baochip/longbao/longbao_hdi_v1/longbao_hdi_v1.kicad_pcb

## KiCad design longbao_hdi_v1/longbao_hdi_v1.kicad_pcb (2026-10-25)

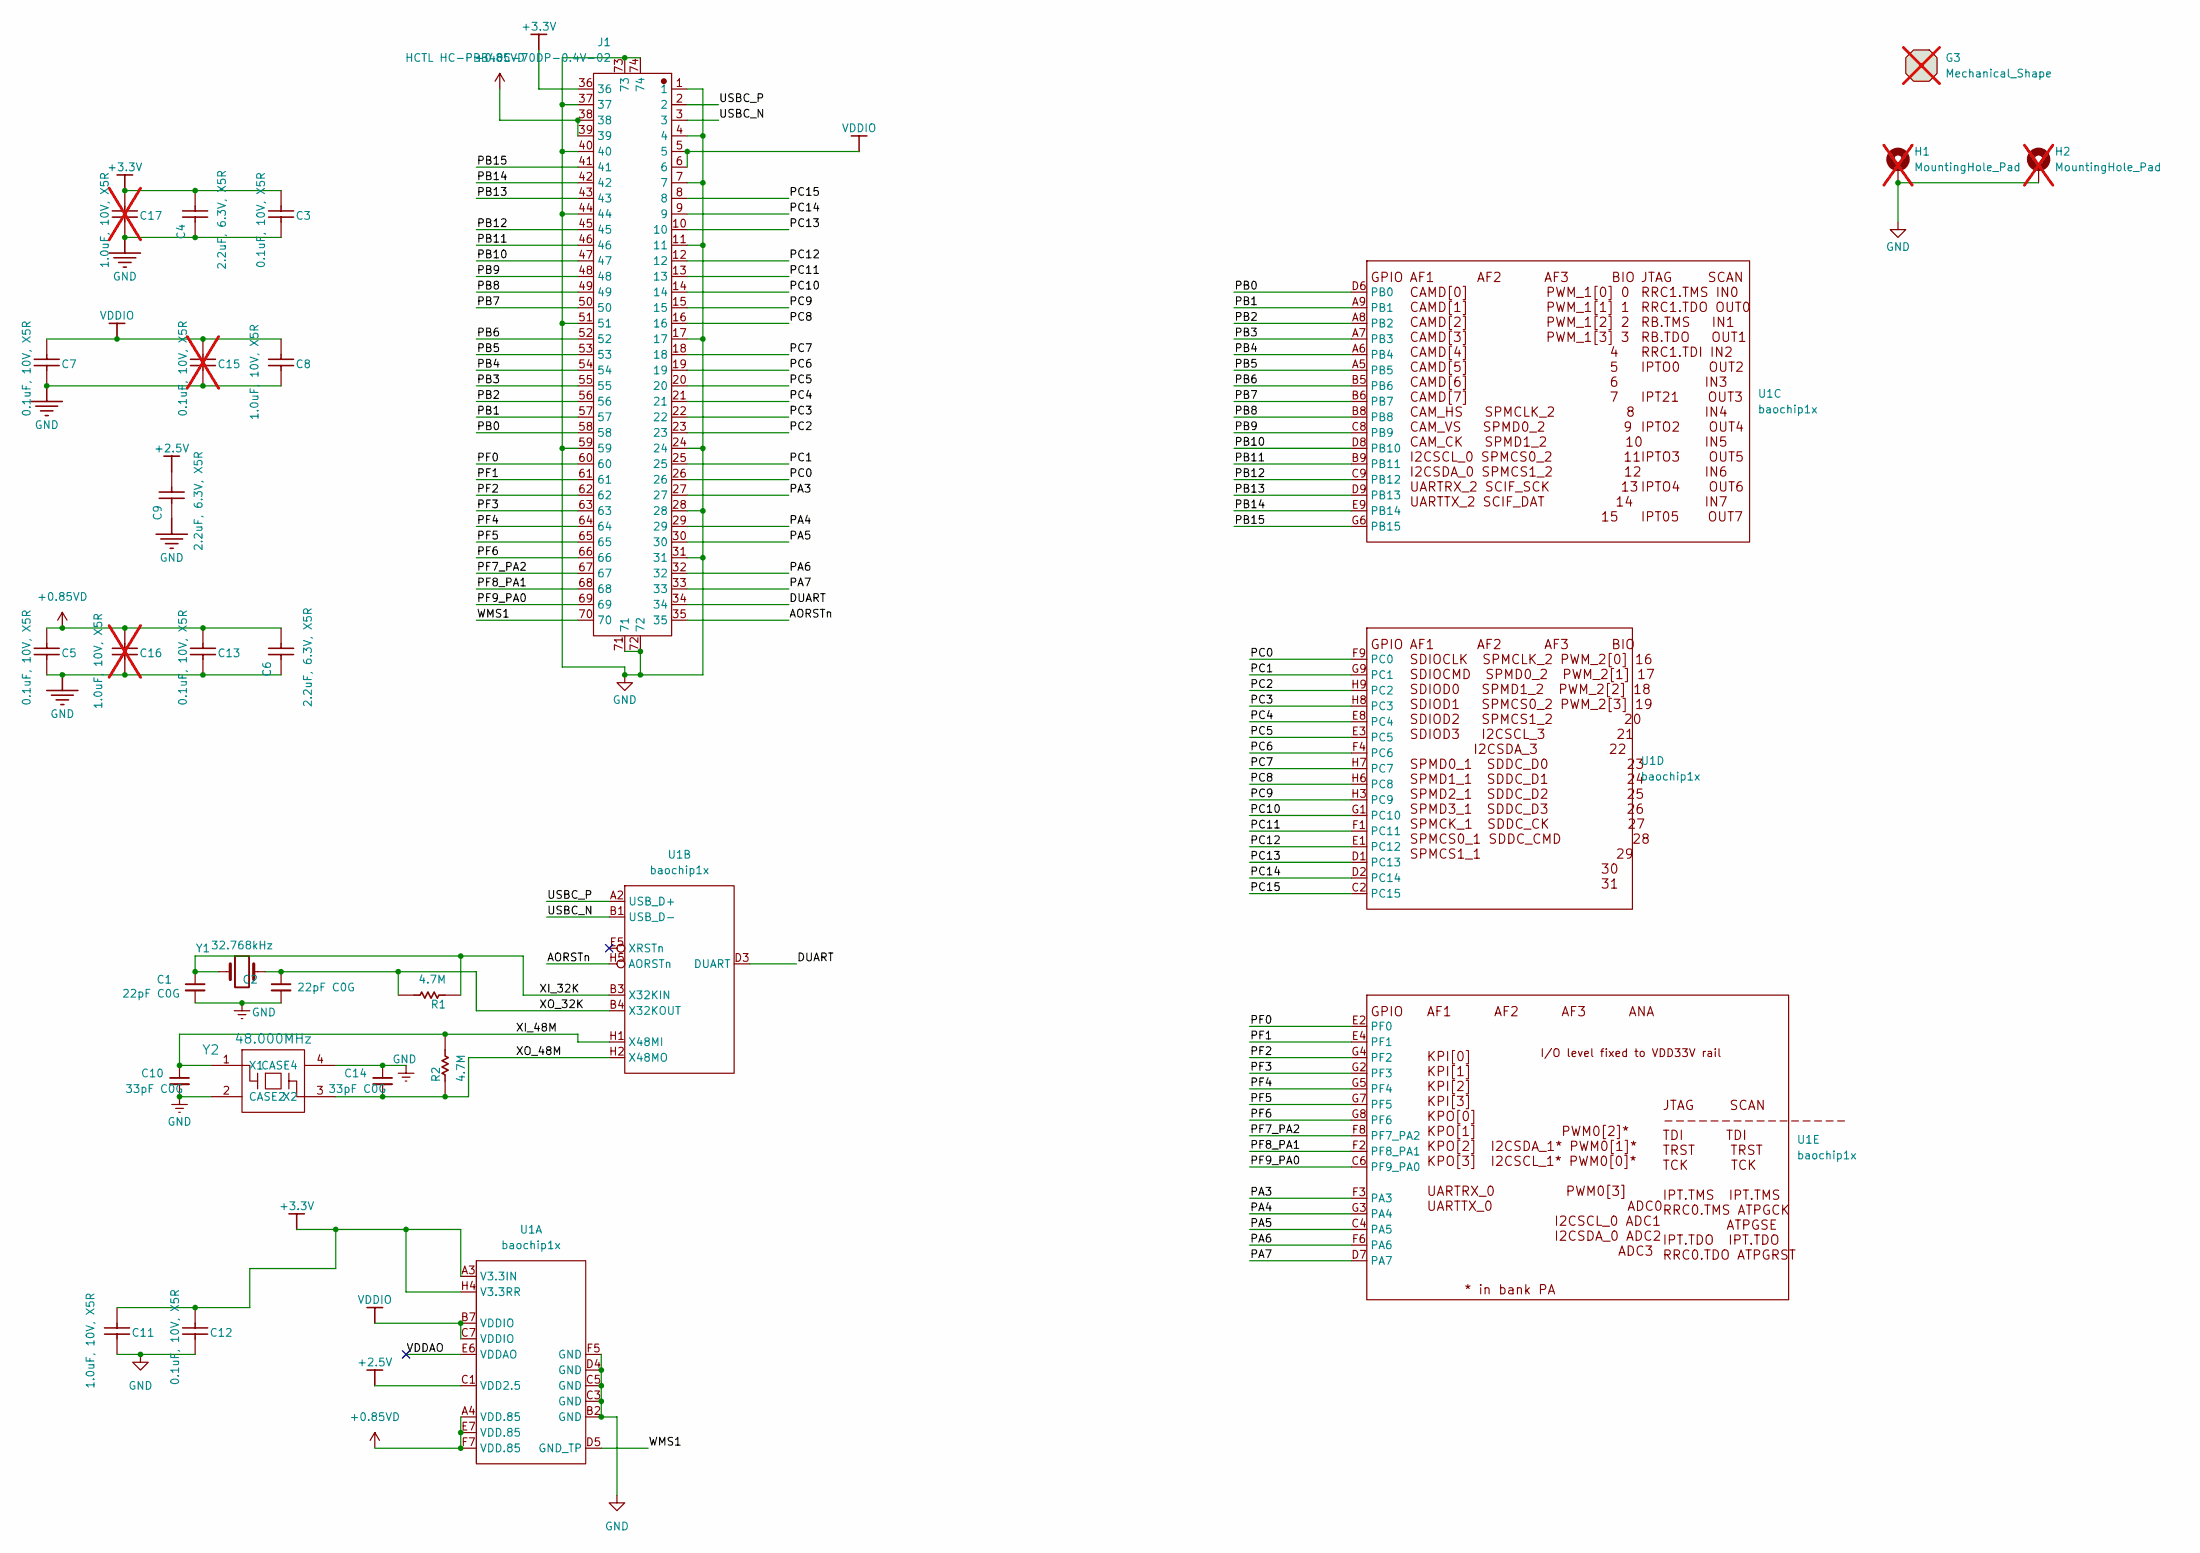
[picture p1: schematic longbao_hdi_v1.kicad_sch]

Parts:
C1, C2: 22pF C0G; C_0201_0603Metric; Rating C0G 50V 0201; MPN ANY; LCSC C57783
C3, C5, C7, C12, C13: 0.1uF, 10V, X5R; C_0201_0603Metric; MPN CL05B104KO5NNNC; LCSC C76934
C4, C6, C9: 2.2uF, 6.3V, X5R; C_0201_0603Metric; MPN GRM033R60J225ME47D; LCSC C76933
C8, C11: 1.0uF, 10V, X5R; C_0201_0603Metric; MPN CL05A105KA5NQNC; LCSC C76935
C10, C14: 33pF C0G; C_0201_0603Metric; Rating C0G 50V 0201; MPN ANY; LCSC C56903
C15: 0.1uF, 10V, X5R; C_0201_0603Metric; MPN CL05B104KO5NNNC; LCSC C76934; not fitted
C16, C17: 1.0uF, 10V, X5R; C_0201_0603Metric; MPN CL05A105KA5NQNC; LCSC C76935; not fitted
G3: Mechanical_Shape; CE-Logo_8.5x6mm_SilkScreen; not fitted
H1, H2: MountingHole_Pad; MountingHole_2.2mm_M2_DIN965_Pad; not fitted
J1: HCTL HC-PBB40C-70DP-0.4V-02; HC-PBB40C-70DP-0.4V-02; LCSC C19089236
R1, R2: 4.7M; R_0402_1005Metric; MPN ANY; LCSC C474132
U1: baochip1x; WLCSP-71_9x8_4.062x3.762mm; LCSC C9900312212
Y1: 32.768kHz; Crystal_SMD_TXC_9HT11-2Pin_2.0x1.2mm; LCSC C55208
Y2: 48.000MHz; Crystal_SMD_3225-4Pin_3.2x2.5mm; LCSC C2892060

Connections:
+0.85VD: C5.1, C6.2, C13.1, C16.1, J1.38, J1.39, U1.A4 (VDD.85), U1.E7 (VDD.85), U1.F7 (VDD.85)
+2.5V: C9.2, U1.C1 (VDD2.5)
+3.3V: C3.1, C4.2, C11.1, C12.1, C17.1, J1.36, U1.A3 (V3.3IN), U1.H4 (V3.3RR)
/AORSTn: J1.35, U1.H5 (AORSTn)
/DUART: J1.34, U1.D3 (DUART)
/PA3: J1.27, U1.F3 (PA3)
/PA4: J1.29, U1.G3 (PA4)
/PA5: J1.30, U1.C4 (PA5)
/PA6: J1.32, U1.F6 (PA6)
/PA7: J1.33, U1.D7 (PA7)
/PB0: J1.58, U1.D6 (PB0)
/PB1: J1.57, U1.A9 (PB1)
/PB2: J1.56, U1.A8 (PB2)
/PB3: J1.55, U1.A7 (PB3)
/PB4: J1.54, U1.A6 (PB4)
/PB5: J1.53, U1.A5 (PB5)
/PB6: J1.52, U1.B5 (PB6)
/PB7: J1.50, U1.B6 (PB7)
/PB8: J1.49, U1.B8
/PB9: J1.48, U1.C8 (PB9)
/PB10: J1.47, U1.D8 (PB10)
/PB11: J1.46, U1.B9 (PB11)
/PB12: J1.45, U1.C9 (PB12)
/PB13: J1.43, U1.D9 (PB13)
/PB14: J1.42, U1.E9 (PB14)
/PB15: J1.41, U1.G6 (PB15)
/PC0: J1.26, U1.F9 (PC0)
/PC1: J1.25, U1.G9 (PC1)
/PC2: J1.23, U1.H9 (PC2)
/PC3: J1.22, U1.H8 (PC3)
/PC4: J1.21, U1.E8 (PC4)
/PC5: J1.20, U1.E3 (PC5)
/PC6: J1.19, U1.F4 (PC6)
/PC7: J1.18, U1.H7 (PC7)
/PC8: J1.16, U1.H6 (PC8)
/PC9: J1.15, U1.H3 (PC9)
/PC10: J1.14, U1.G1 (PC10)
/PC11: J1.13, U1.F1 (PC11)
/PC12: J1.12, U1.E1 (PC12)
/PC13: J1.10, U1.D1 (PC13)
/PC14: J1.9, U1.D2 (PC14)
/PC15: J1.8, U1.C2 (PC15)
/PF0: J1.60, U1.E2 (PF0)
/PF1: J1.61, U1.E4 (PF1)
/PF2: J1.62, U1.G4 (PF2)
/PF3: J1.63, U1.G2 (PF3)
/PF4: J1.64, U1.G5 (PF4)
/PF5: J1.65, U1.G7 (PF5)
/PF6: J1.66, U1.G8 (PF6)
/PF7_PA2: J1.67, U1.F8 (PF7_PA2)
/PF8_PA1: J1.68, U1.F2 (PF8_PA1)
/PF9_PA0: J1.69, U1.C6 (PF9_PA0)
/USBC_N: J1.3, U1.B1 (USB_D-)
/USBC_P: J1.2, U1.A2 (USB_D+)
/VDDAO: U1.E6 (VDDAO)
/WMS1: J1.70, U1.D5 (GND_TP)
/XI_32K: C1.1, R1.1, U1.B3 (X32KIN), Y1.1
/XI_48M: C10.1, R2.2, U1.H1 (X48MI), Y2.1 (X1)
/XO_32K: C2.1, R1.2, U1.B4 (X32KOUT), Y1.2
/XO_48M: C14.2, R2.1, U1.H2 (X48MO), Y2.3 (X2)
GND: C1.2, C2.2, C3.2, C4.1, C5.2, C6.1, C7.2, C8.2, C9.1, C10.2, C11.2, C12.2, C13.2, C14.1, C15.2, C16.2, C17.2, H1.1 (1_1), H2.1 (1_1), J1.1, J1.4, J1.7, J1.11, J1.17, J1.24, J1.28, J1.31, J1.37, J1.40, J1.44, J1.51, J1.59, J1.71, J1.72, J1.73, J1.74, U1.B2 (GND), U1.C3 (GND), U1.C5 (GND), U1.D4 (GND), U1.F5 (GND), Y2.2 (CASE2), Y2.4 (CASE4)
VDDIO: C7.1, C8.1, C15.1, J1.5, J1.6, U1.B7 (VDDIO), U1.C7 (VDDIO)

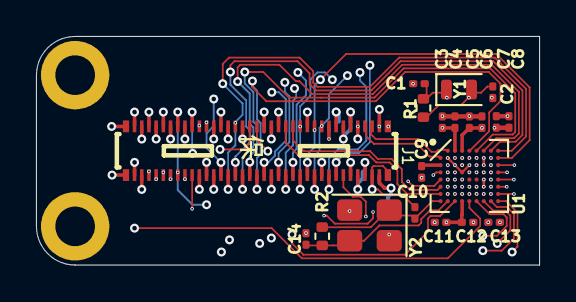
[picture p2: board longbao_hdi_v1.kicad_pcb from above]

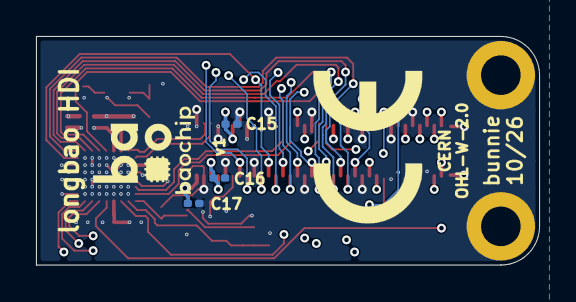
[picture p3: board longbao_hdi_v1.kicad_pcb from below]

Board: 6 copper layers, 28.0 x 12.7 mm, 28 parts (5 on the bottom side), 61 nets.

Other parts of the board:
G1, G2: LOGO
