baochip/longbao/longbao_carrier_v1/longbao_carrier_v1.kicad_pcb

## KiCad design longbao_carrier_v1/longbao_carrier_v1.kicad_pcb (2026-10-25)

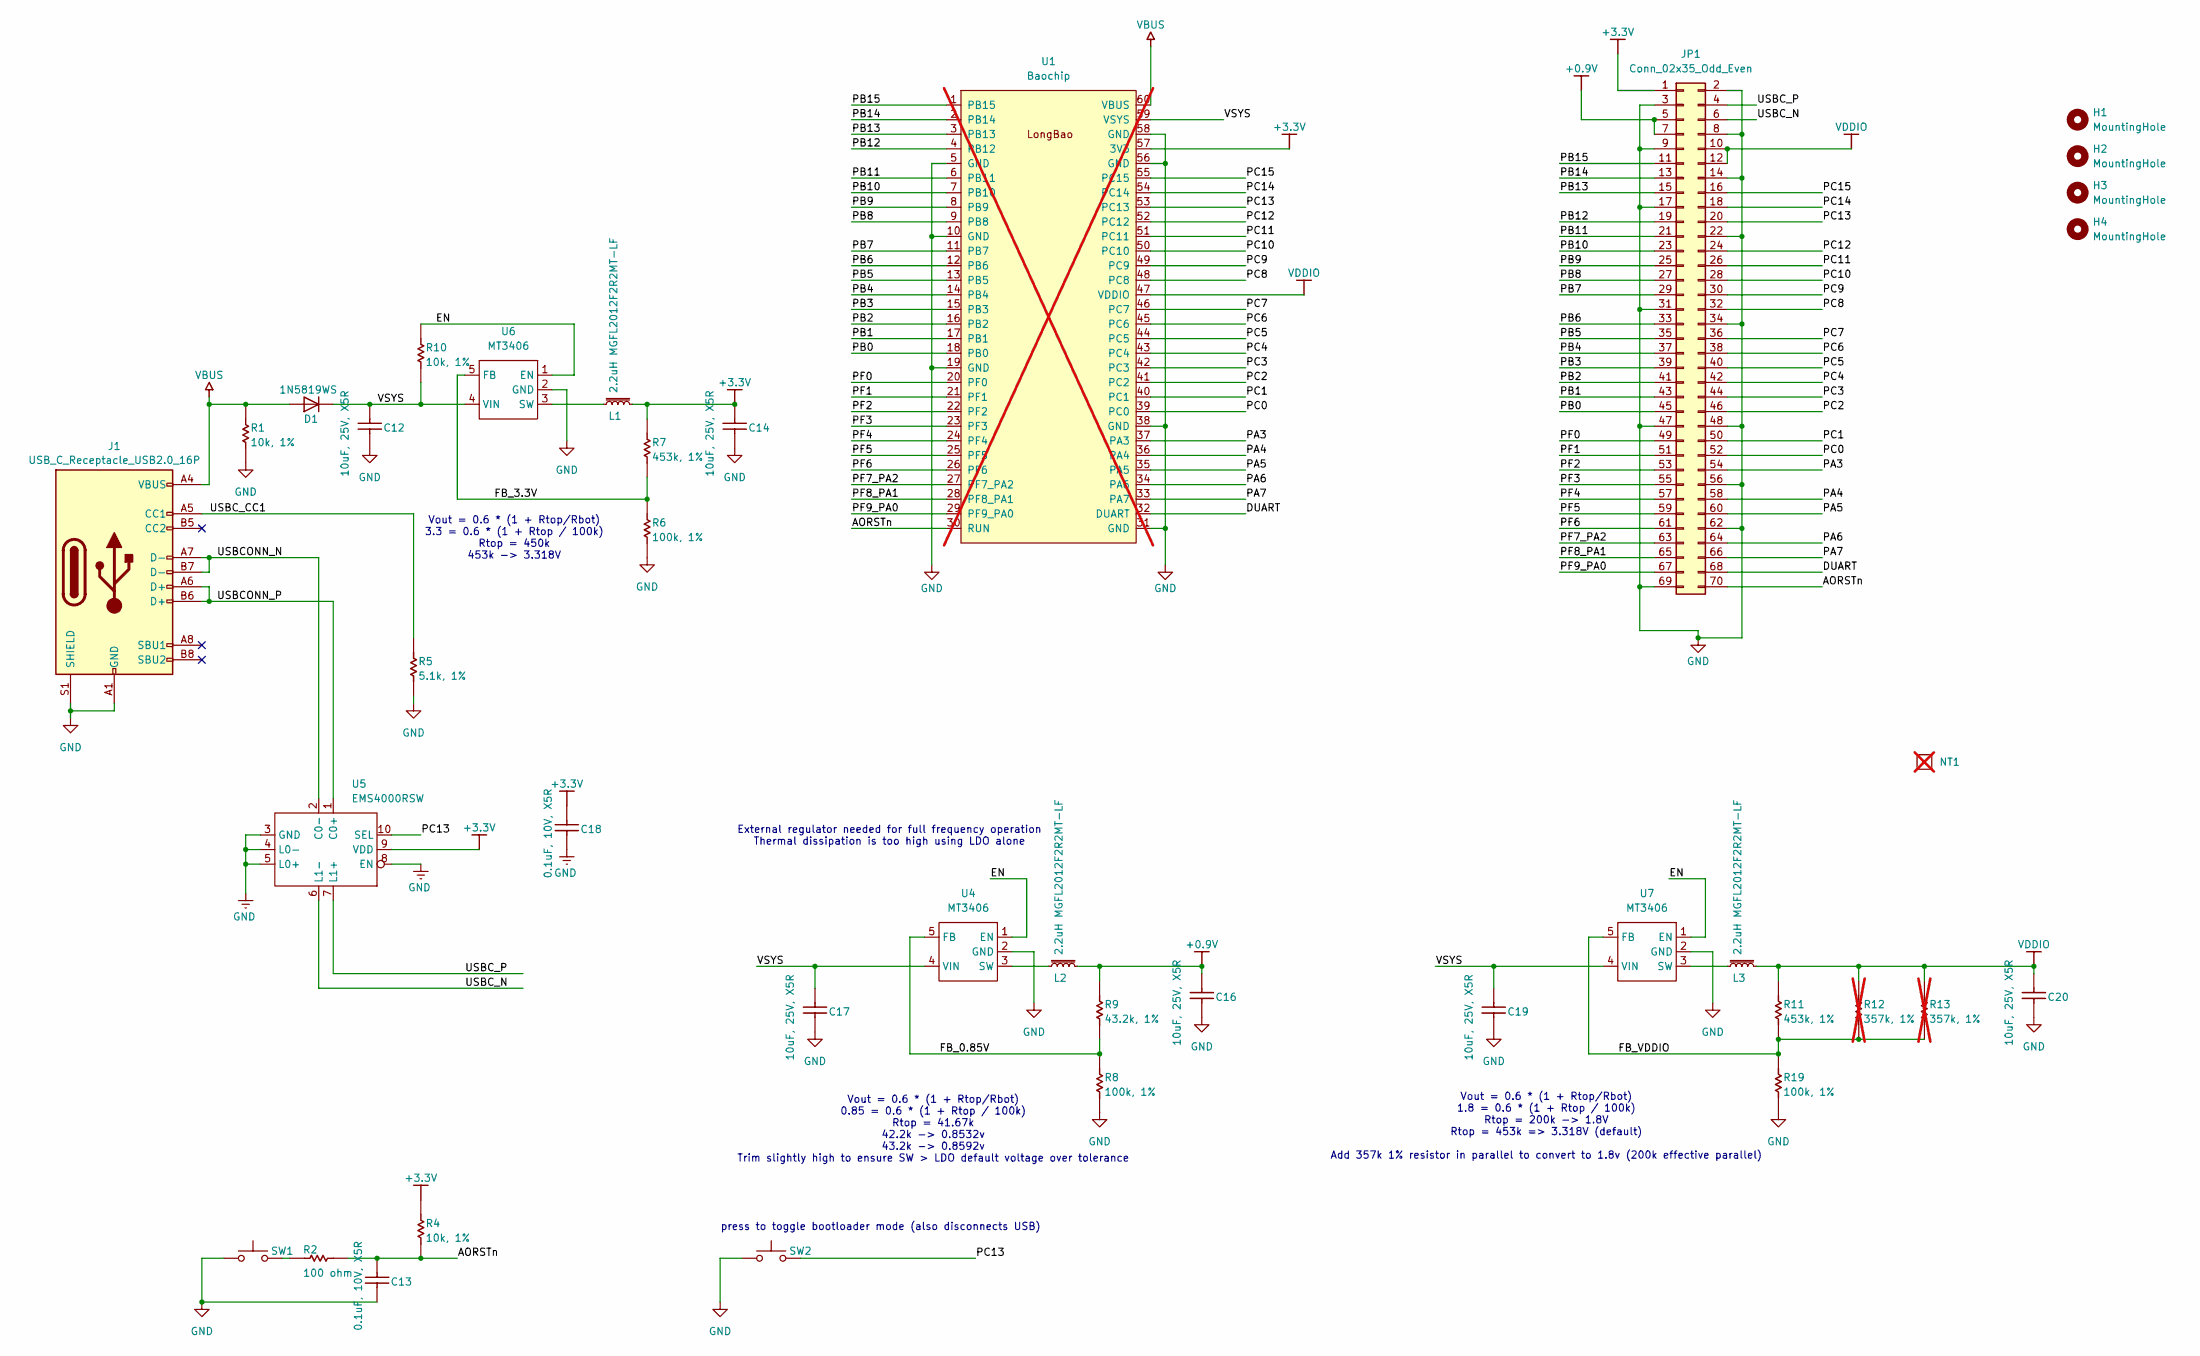
[picture p4: schematic longbao_carrier_v1.kicad_sch]

Parts:
C12, C14, C16, C17, C19, C20: 10uF, 25V, X5R; C_0603_1608Metric; MPN CL10A106MA8NRNC; LCSC C96446
C13, C18: 0.1uF, 10V, X5R; C_0201_0603Metric; MPN CL05B104KO5NNNC; LCSC C76934
D1: 1N5819WS; D_SOD-323; MPN SD103AWS; LCSC C191023
H1, H2, H3, H4: MountingHole; MountingHole_2.2mm_M2_DIN965
J1: USB_C_Receptacle_USB2.0_16P; USB_C_Receptacle_HRO_TYPE-C-31-M-12; LCSC C165948
JP1: Conn_02x35_Odd_Even; HC-PBB40C-70DS-0.4V-2.5-02; LCSC C19089322
L1, L2, L3: 2.2uH MGFL2012F2R2MT-LF; L_0805_2012Metric; LCSC C281115
NT1: CE-Logo_8.5x6mm_SilkScreen; not fitted
R1, R4, R10: 10k, 1%; R_0201_0603Metric; MPN ANY; LCSC C106225
R2: 100 ohm; R_0402_1005Metric; MPN ANY; LCSC C106232
R5: 5.1k, 1%; R_0402_1005Metric; MPN ANY; LCSC C25905
R6, R8, R19: 100k, 1%; R_0201_0603Metric; MPN ANY; LCSC C106224
R7, R11: 453k, 1%; R_0201_0603Metric; MPN ANY; LCSC C423509
R9: 43.2k, 1%; R_0201_0603Metric; MPN ANY; LCSC C158519
R12: 357k, 1%; R_1206_3216Metric; MPN ANY; LCSC DNP; not fitted
R13: 357k, 1%; R_Axial_DIN0207_L6.3mm_D2.5mm_P7.62mm_Horizontal; MPN ANY; LCSC DNP; not fitted
SW1, SW2: SW_Push; TS3425BA; LCSC C2681476
U1: Baochip; Longbao_Vendor_Substrate; not fitted
U4, U6, U7: MT3406; SOT-23-5; LCSC C22462728
U5: EMS4000RSW; QFN-10_1.4x1.8_Pitch0.4mm; LCSC C49186227

Connections:
+0.9V: C16.1, JP1.5, JP1.7, L2.2, R9.1
+3.3V: C14.1, C18.1, JP1.1, L1.2, R4.1, R7.1, U1.57 (3V3), U5.9 (VDD)
/AORSTn: C13.1, JP1.70, R2.2, R4.2, U1.30 (RUN)
/DUART: JP1.68, U1.32 (DUART)
/EN: R10.1, U4.1 (EN), U6.1 (EN), U7.1 (EN)
/FB_0.85V: R8.1, R9.2, U4.5 (FB)
/FB_3.3V: R6.1, R7.2, U6.5 (FB)
/FB_VDDIO: R11.2, R12.2, R13.2, R19.1, U7.5 (FB)
/PA3: JP1.54, U1.37 (PA3)
/PA4: JP1.58, U1.36 (PA4)
/PA5: JP1.60, U1.35 (PA5)
/PA6: JP1.64, U1.34 (PA6)
/PA7: JP1.66, U1.33 (PA7)
/PB0: JP1.45, U1.18 (PB0)
/PB1: JP1.43, U1.17 (PB1)
/PB2: JP1.41, U1.16 (PB2)
/PB3: JP1.39, U1.15 (PB3)
/PB4: JP1.37, U1.14 (PB4)
/PB5: JP1.35, U1.13 (PB5)
/PB6: JP1.33, U1.12 (PB6)
/PB7: JP1.29, U1.11 (PB7)
/PB8: JP1.27, U1.9 (PB8)
/PB9: JP1.25, U1.8 (PB9)
/PB10: JP1.23, U1.7 (PB10)
/PB11: JP1.21, U1.6 (PB11)
/PB12: JP1.19, U1.4 (PB12)
/PB13: JP1.15, U1.3 (PB13)
/PB14: JP1.13, U1.2 (PB14)
/PB15: JP1.11, U1.1 (PB15)
/PC0: JP1.52, U1.39 (PC0)
/PC1: JP1.50, U1.40 (PC1)
/PC2: JP1.46, U1.41 (PC2)
/PC3: JP1.44, U1.42 (PC3)
/PC4: JP1.42, U1.43 (PC4)
/PC5: JP1.40, U1.44 (PC5)
/PC6: JP1.38, U1.45 (PC6)
/PC7: JP1.36, U1.46 (PC7)
/PC8: JP1.32, U1.48 (PC8)
/PC9: JP1.30, U1.49 (PC9)
/PC10: JP1.28, U1.50 (PC10)
/PC11: JP1.26, U1.51 (PC11)
/PC12: JP1.24, U1.52 (PC12)
/PC13: JP1.20, SW2.2, U1.53 (PC13), U5.10 (SEL)
/PC14: JP1.18, U1.54 (PC14)
/PC15: JP1.16, U1.55 (PC15)
/PF0: JP1.49, U1.20 (PF0)
/PF1: JP1.51, U1.21 (PF1)
/PF2: JP1.53, U1.22 (PF2)
/PF3: JP1.55, U1.23 (PF3)
/PF4: JP1.57, U1.24 (PF4)
/PF5: JP1.59, U1.25 (PF5)
/PF6: JP1.61, U1.26 (PF6)
/PF7_PA2: JP1.63, U1.27 (PF7_PA2)
/PF8_PA1: JP1.65, U1.28 (PF8_PA1)
/PF9_PA0: JP1.67, U1.29 (PF9_PA0)
/USBCONN_N: J1.A7 (D-), J1.B7 (D-), U5.2 (C0-)
/USBCONN_P: J1.A6 (D+), J1.B6 (D+), U5.1 (C0+)
/USBC_CC1: J1.A5 (CC1), R5.2
/USBC_N: JP1.6, U5.6 (L1-)
/USBC_P: JP1.4, U5.7 (L1+)
/VSYS: C12.1, C17.1, C19.1, D1.1 (K), R10.2, U1.59 (VSYS), U4.4 (VIN), U6.4 (VIN), U7.4 (VIN)
GND: C12.2, C13.2, C14.2, C16.2, C17.2, C18.2, C19.2, C20.2, J1.A1 (GND), J1.A12 (GND), J1.B1 (GND), J1.B12 (GND), J1.S1 (SHIELD), JP1.2, JP1.3, JP1.8, JP1.9, JP1.14, JP1.17, JP1.22, JP1.31, JP1.34, JP1.47, JP1.48, JP1.56, JP1.62, JP1.69, R1.2, R5.1, R6.2, R8.2, R19.2, SW1.1, SW2.1, U1.5 (GND), U1.10 (GND), U1.19 (GND), U1.31 (GND), U1.38 (GND), U1.56 (GND), U1.58 (GND), U4.2 (GND), U5.3 (GND), U5.4 (L0-), U5.5 (L0+), U5.8 (EN), U6.2 (GND), U7.2 (GND)
unnamed: R2.1, SW1.2
unnamed: L2.1, U4.3 (SW)
unnamed: L1.1, U6.3 (SW)
unnamed: L3.1, U7.3 (SW)
VBUS: D1.2 (A), J1.A4 (VBUS), J1.A9 (VBUS), J1.B4 (VBUS), J1.B9 (VBUS), R1.1, U1.60 (VBUS)
VDDIO: C20.1, JP1.10, JP1.12, L3.2, R11.1, R12.1, R13.1, U1.47 (VDDIO)

Notes on the sheet:
Vout = 0.6 * (1 + Rtop/Rbot) 3.3 = 0.6 * (1 + Rtop / 100k) Rtop = 450k 453k -> 3.318V
Vout = 0.6 * (1 + Rtop/Rbot) 1.8 = 0.6 * (1 + Rtop / 100k) Rtop = 200k -> 1.8V Rtop = 453k => 3.318V (default) Add 357k 1% resistor in parallel to convert to 1.8v (200k effective parallel)
External regulator needed for full frequency operation Thermal dissipation is too high using LDO alone
press to toggle bootloader mode (also disconnects USB)
Vout = 0.6 * (1 + Rtop/Rbot) 0.85 = 0.6 * (1 + Rtop / 100k) Rtop = 41.67k 42.2k -> 0.8532v 43.2k -> 0.8592v Trim slightly high to ensure SW > LDO default voltage over tolerance

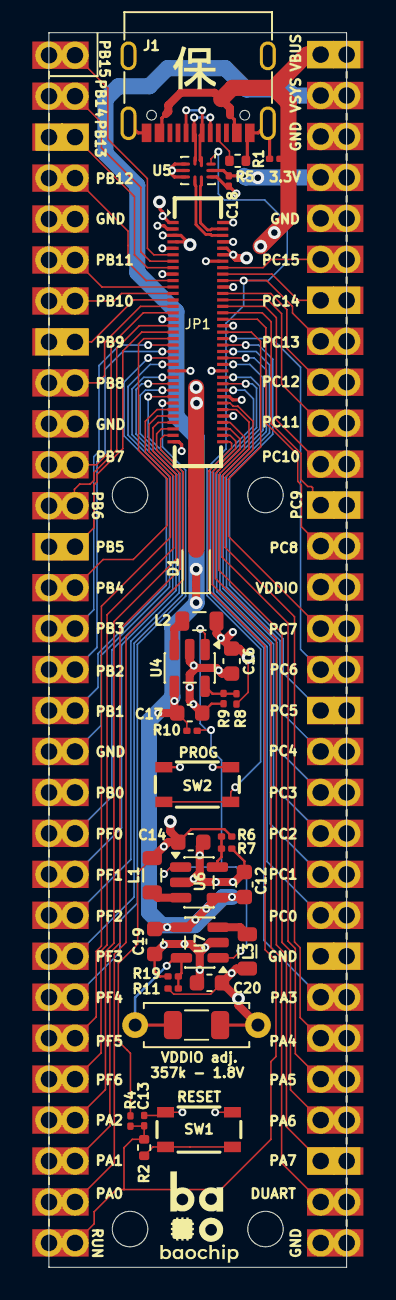
[picture p5: board longbao_carrier_v1.kicad_pcb from above]

Board: 4 copper layers, 18.5 x 76.6 mm, 39 parts (1 on the bottom side), 68 nets.
